CGainsWorks/emb-mixed-signal-daq/hardware/docs/noise_budget.md

<!-- Generated by scripts/run_all.py from model/daqmodel. Edit the model, not this file. -->

# Noise budget

Calculated from the specification before the front end was simulated and
before the behavioural converter existed. Each contributor has its own
closed form transfer function in
[model/daqmodel/noise_budget.py](../../model/daqmodel/noise_budget.py); none
of it uses a circuit solver. The ngspice deck generated from the same
netlist is the independent check (`scripts/run_ngspice.py`, results in
[test-results/noise-floor/ngspice_crosscheck.csv](../../test-results/noise-floor/ngspice_crosscheck.csv)).

## Method

* Temperature 27 degC, the ngspice default, so both routes use the same
  4kT.
* Output referred power spectral density at the converter pins is summed
  over contributors, weighted by the sinc4 decimator's |H(f)|^2 and
  integrated. The decimator response is periodic in f_mod, so the integral
  runs to 2.458 MHz and counts the analogue noise that folds back
  from around the modulator clock. The converter's own noise is defined in
  band and is integrated to f_mod / 2 only.
* Equivalent noise bandwidth of the decimator at 2400 SPS:
  **575.24 Hz**.
* Input referred figures divide by the DC gain of the gain setting.
* Modulator quantisation noise uses the linear model (white error of
  variance 1/3 shaped by the NTF). A 1-bit loop is not linear, so this is a
  conservative estimate; the behavioural model measures the real figure.

## Allowances

The amplifier, converter and reference figures are allowances: what the
budget permits each part to contribute. They are not quoted from a
datasheet and part selection has to meet them.

| Part | Allowance |
|---|---|
| Gain stage amplifiers (zero drift, so no 1/f term) | e_n 6 nV/rtHz, i_n 0.3 pA/rtHz, each |
| Converter, referred to its input | 20 nV/rtHz |
| Reference after its RC filter | 20 nV/rtHz |

## Results by gain

### Gain 1 (actual 1.0000)

| Contributor | Block | Density, nV/rtHz at 10 Hz | rms, nV | Share of power, % | In SPICE deck |
|---|---|---|---|---|---|
| Sensor resistance, 2 x 175 ohm | source | 2.41 | 56.7 | 0.8 | yes |
| Protection resistors, 2 x 499 ohm | input filter | 4.07 | 95.8 | 2.2 | yes |
| Amplifier voltage noise, 2 x 6 nV/rtHz | gain stage | 8.49 | 200.3 | 9.7 | yes |
| Amplifier current noise, 2 x 0.3 pA/rtHz in R_leg | gain stage | 0.29 | 6.7 | 0.0 | yes |
| Feedback resistors R_f, 2 x 2490 ohm | gain stage | 9.09 | 214.4 | 11.1 | yes |
| Anti-alias resistors, 2 x 499 ohm | anti-alias filter | 4.07 | 96.0 | 2.2 | yes |
| Converter input noise, 20 nV/rtHz | converter | 20.00 | 471.8 | 53.7 | no |
| Modulator quantisation (linear model) | converter |  | 290.6 | 20.4 | no |

Total **644.1 nV rms** input referred against a target of
750 nV: meets it with
1.32 dB of margin. The white estimate (low frequency density times
the equivalent noise bandwidth) is 652.6 nV, so the
filter poles above 10 kHz change the total by
1.3 percent. Noise
folded back from above f_mod / 2 is 0.040 percent of the
power. Reference noise adds 339.2 nV rms to a full
scale sine and nothing at zero input.

### Gain 8 (actual 7.9650)

| Contributor | Block | Density, nV/rtHz at 10 Hz | rms, nV | Share of power, % | In SPICE deck |
|---|---|---|---|---|---|
| Sensor resistance, 2 x 175 ohm | source | 2.41 | 56.7 | 5.1 | yes |
| Protection resistors, 2 x 499 ohm | input filter | 4.07 | 95.8 | 14.5 | yes |
| Amplifier voltage noise, 2 x 6 nV/rtHz | gain stage | 8.49 | 200.3 | 63.3 | yes |
| Amplifier current noise, 2 x 0.3 pA/rtHz in R_leg | gain stage | 0.29 | 6.7 | 0.1 | yes |
| Feedback resistors R_f, 2 x 2490 ohm | gain stage | 1.14 | 26.9 | 1.1 | yes |
| Gain resistor R_G, 715 ohm | gain stage | 3.01 | 71.0 | 8.0 | yes |
| Anti-alias resistors, 2 x 499 ohm | anti-alias filter | 0.51 | 12.1 | 0.2 | yes |
| Converter input noise, 20 nV/rtHz | converter | 2.51 | 59.2 | 5.5 | no |
| Modulator quantisation (linear model) | converter |  | 36.5 | 2.1 | no |

Total **251.6 nV rms** input referred against a target of
400 nV: meets it with
4.03 dB of margin. The white estimate (low frequency density times
the equivalent noise bandwidth) is 255.7 nV, so the
filter poles above 10 kHz change the total by
1.6 percent. Noise
folded back from above f_mod / 2 is 0.128 percent of the
power. Reference noise adds 42.6 nV rms to a full
scale sine and nothing at zero input.

### Gain 32 (actual 31.7407)

| Contributor | Block | Density, nV/rtHz at 10 Hz | rms, nV | Share of power, % | In SPICE deck |
|---|---|---|---|---|---|
| Sensor resistance, 2 x 175 ohm | source | 2.41 | 56.7 | 5.9 | yes |
| Protection resistors, 2 x 499 ohm | input filter | 4.07 | 95.8 | 16.9 | yes |
| Amplifier voltage noise, 2 x 6 nV/rtHz | gain stage | 8.49 | 200.3 | 73.8 | yes |
| Amplifier current noise, 2 x 0.3 pA/rtHz in R_leg | gain stage | 0.29 | 6.7 | 0.1 | yes |
| Feedback resistors R_f, 2 x 2490 ohm | gain stage | 0.29 | 6.8 | 0.1 | yes |
| Gain resistor R_G, 162 ohm | gain stage | 1.59 | 37.5 | 2.6 | yes |
| Anti-alias resistors, 2 x 499 ohm | anti-alias filter | 0.13 | 3.0 | 0.0 | yes |
| Converter input noise, 20 nV/rtHz | converter | 0.63 | 14.9 | 0.4 | no |
| Modulator quantisation (linear model) | converter |  | 9.2 | 0.2 | no |

Total **233.1 nV rms** input referred against a target of
320 nV: meets it with
2.75 dB of margin. The white estimate (low frequency density times
the equivalent noise bandwidth) is 236.9 nV, so the
filter poles above 10 kHz change the total by
1.7 percent. Noise
folded back from above f_mod / 2 is 0.134 percent of the
power. Reference noise adds 10.7 nV rms to a full
scale sine and nothing at zero input.

### Gain 128 (actual 128.0408)

| Contributor | Block | Density, nV/rtHz at 10 Hz | rms, nV | Share of power, % | In SPICE deck |
|---|---|---|---|---|---|
| Sensor resistance, 2 x 175 ohm | source | 2.41 | 56.7 | 6.1 | yes |
| Protection resistors, 2 x 499 ohm | input filter | 4.07 | 95.8 | 17.3 | yes |
| Amplifier voltage noise, 2 x 6 nV/rtHz | gain stage | 8.49 | 200.3 | 75.8 | yes |
| Amplifier current noise, 2 x 0.3 pA/rtHz in R_leg | gain stage | 0.29 | 6.7 | 0.1 | yes |
| Feedback resistors R_f, 2 x 2490 ohm | gain stage | 0.07 | 1.7 | 0.0 | yes |
| Gain resistor R_G, 39.2 ohm | gain stage | 0.80 | 18.9 | 0.7 | yes |
| Anti-alias resistors, 2 x 499 ohm | anti-alias filter | 0.03 | 0.7 | 0.0 | yes |
| Converter input noise, 20 nV/rtHz | converter | 0.16 | 3.7 | 0.0 | no |
| Modulator quantisation (linear model) | converter |  | 2.3 | 0.0 | no |

Total **230.1 nV rms** input referred against a target of
300 nV: meets it with
2.31 dB of margin. The white estimate (low frequency density times
the equivalent noise bandwidth) is 233.9 nV, so the
filter poles above 10 kHz change the total by
1.7 percent. Noise
folded back from above f_mod / 2 is 0.134 percent of the
power. Reference noise adds 2.6 nV rms to a full
scale sine and nothing at zero input.

## What the budget says about the design

* At gain 1 the converter's own noise and the modulator quantisation
  dominate, followed by the two feedback resistors. A unity gain buffer
  without R_f would be quieter but the resistors stay because the gain is
  switched by R_G alone.
* From gain 8 up the gain stage amplifiers' voltage noise dominates
  (63 percent of the power at gain 8,
  76 percent at gain 128) and the protection
  resistors are most of the rest, so the noise stops falling with gain.
  Lowering it further means a quieter amplifier or less protection
  resistance, not more gain.
* Amplifier current noise is negligible with this source impedance; it
  would matter only above about 20 kohm per leg.
* Analogue alias rejection at f_mod - 500 Hz is
  **66.9 dB** from the two RC poles
  (11.24 kHz and 15.19 kHz), against a target of
  60 dB.
* Predicted SNR for a -1 dBFS sine at gain 1, reference noise included:
  **126.9 dB**, an ENOB of 20.79 bits before distortion.
