CGainsWorks/emb-mixed-signal-daq/test-results/enob-snr/spectra.png

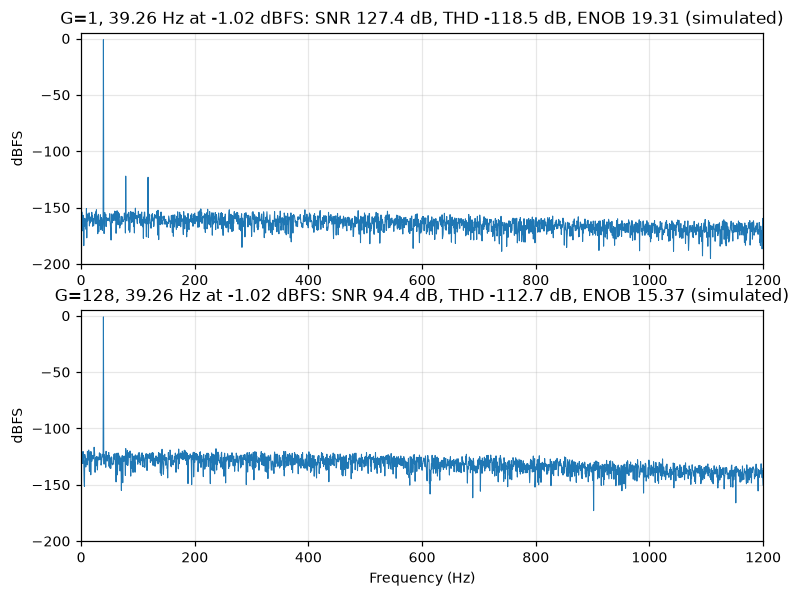
test-results/enob-snr/spectra.png
