CGainsWorks/emb-mixed-signal-daq/test-results/calibration/firmware_in_loop.csv

gain | samples | frames | crc_errors | sequence_gaps | raw_codes_match_model | coefficients_match_python | calibrated_samples_match_python | offset_q8 | gain_q29 | snr_dB_firmware_output | enob_bits_firmware_output
1 | 4096 | 258 | 0 | 0 | yes | yes | 4096/4096 | -31288 | 536896879 | 127.425 | 19.307
128 | 4096 | 258 | 0 | 0 | yes | yes | 4096/4096 | -832220 | 537015455 | 94.351 | 15.371
