CGainsWorks/emb-mixed-signal-daq/test-results/calibration/coefficients.csv

gain | vcal_nV | offset_q8 | gain_q29
1 | 2250000000 | -31372 | 536896937
8 | 281250000 | -75400 | 539418625
32 | 70312500 | -225292 | 541331474
128 | 17578125 | -826804 | 537016852
