CGainsWorks/emb-mixed-signal-daq/test-results/calibration/validation.csv

gain | nominal_V | true_V | dmm_V | daq_raw_V | daq_calibrated_V | raw_error_ppm_fsr | cal_error_vs_dmm_ppm_fsr | cal_error_vs_true_ppm_fsr
1 | -2.2500000 | -2.250001126 | -2.250006378 | -2.249919344 | -2.249991886 | 17.41 | 2.898 | 1.848
1 | -1.8000000 | -1.800000901 | -1.800005080 | -1.799941016 | -1.799991746 | 12.81 | 2.667 | 1.831
1 | -1.3500000 | -1.350000676 | -1.350003783 | -1.349964421 | -1.349993338 | 7.87 | 2.089 | 1.468
1 | -0.9000000 | -0.900000450 | -0.900002485 | -0.899988003 | -0.899995107 | 2.90 | 1.476 | 1.069
1 | -0.4500000 | -0.450000225 | -0.450001187 | -0.450012395 | -0.449997686 | -2.24 | 0.700 | 0.508
1 | -0.0000000 | -0.000000000 | 0.000000110 | -0.000036377 | 0.000000144 | -7.30 | 0.007 | 0.029
1 | 0.4500000 | 0.450000225 | 0.450001408 | 0.449939715 | 0.449998049 | -12.34 | -0.672 | -0.435
1 | 0.9000000 | 0.900000450 | 0.900002706 | 0.899916412 | 0.899996560 | -17.26 | -1.229 | -0.778
1 | 1.3500000 | 1.350000676 | 1.350004003 | 1.349894451 | 1.349996411 | -21.91 | -1.518 | -0.853
1 | 1.8000000 | 1.800000901 | 1.800005301 | 1.799873309 | 1.799997082 | -26.40 | -1.644 | -0.764
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
