CGainsWorks/emb-mixed-signal-daq/test-results/enob-snr/sine.csv

gain | freq_Hz | level_dBFS | snr_dB | budget_snr_dB | thd_dB | sfdr_dB | sinad_dB | enob_bits | enob_ieee1241_bits
1 | 39.2578 | -1.016 | 127.425 | 126.905 | -118.516 | 121.053 | 117.991 | 19.307 | 19.474
128 | 39.2578 | -1.018 | 94.351 | 94.567 | -112.721 | 115.686 | 94.291 | 15.371 | 15.538
