CGainsWorks/emb-mixed-signal-daq/test-results/linearity/inl.csv

applied_V | measured_V | inl_best_fit_ppm_fsr | inl_end_point_ppm_fsr
-2.3750000 | -2.374912407 | -0.056 | 0.000
-2.2562500 | -2.256167941 | 0.065 | 0.088
-2.1375000 | -2.137423456 | 0.190 | 0.181
-2.0187500 | -2.018679501 | 0.208 | 0.167
-1.9000000 | -1.899935249 | 0.286 | 0.212
-1.7812500 | -1.781191677 | 0.228 | 0.122
-1.6625000 | -1.662447490 | 0.293 | 0.155
-1.5437500 | -1.543703564 | 0.306 | 0.135
-1.4250000 | -1.424959991 | 0.248 | 0.045
-1.3062500 | -1.306216111 | 0.252 | 0.016
-1.1875000 | -1.187472325 | 0.237 | -0.032
-1.0687500 | -1.068728631 | 0.203 | -0.098
-0.9500000 | -0.949985050 | 0.147 | -0.186
-0.8312500 | -0.831241552 | 0.074 | -0.292
-0.7125000 | -0.712498147 | -0.017 | -0.415
-0.5937500 | -0.593754314 | -0.023 | -0.454
-0.4750000 | -0.475010769 | -0.087 | -0.549
-0.3562500 | -0.356267206 | -0.146 | -0.642
-0.2375000 | -0.237523606 | -0.199 | -0.726
-0.1187500 | -0.118780183 | -0.286 | -0.847
0.0000000 | -0.000036117 | -0.246 | -0.838
0.1187500 | 0.118706878 | -0.419 | -1.044
0.2375000 | 0.237450926 | -0.382 | -1.039
0.3562500 | 0.356194340 | -0.472 | -1.161
0.4750000 | 0.474938191 | -0.474 | -1.196
0.5937500 | 0.593682155 | -0.453 | -1.208
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
