CGainsWorks/emb-mixed-signal-daq/test-results/noise-floor/ngspice_crosscheck.csv

gain | ngspice_out_nV_rtHz_1Hz | budget_out_nV_rtHz_1Hz | ngspice_in_nV_rms | budget_in_nV_rms | max_density_rel_dev | integrated_rel_dev | max_transfer_rel_dev
1 | 13.9111 | 13.9111 | 328.243 | 328.243 | 2.86e-07 | 4.34e-07 | 2.77e-07
8 | 81.6372 | 81.6371 | 241.803 | 241.803 | 7.03e-07 | 2.59e-07 | 1.46e-07
32 | 312.6802 | 312.6801 | 232.398 | 232.398 | 5.69e-07 | 4.53e-07 | 3.24e-07
128 | 1248.4597 | 1248.4605 | 230.023 | 230.023 | 6.31e-07 | 1.40e-06 | 1.29e-06
