CGainsWorks/emb-mixed-signal-daq/test-results/noise-floor/noise_floor.csv

gain | simulated_uV_rms | budget_uV_rms | target_uV_rms | peak_to_peak_uV | effective_bits | noise_free_bits | overloads
1 | 0.6008 | 0.6441 | 0.750 | 4.172 | 22.989 | 20.266 | 0
8 | 0.2596 | 0.2516 | 0.400 | 1.714 | 21.199 | 18.476 | 0
32 | 0.2271 | 0.2331 | 0.320 | 1.555 | 19.392 | 16.670 | 0
128 | 0.2336 | 0.2301 | 0.300 | 1.742 | 17.351 | 14.629 | 0
