CGainsWorks/emb-mixed-signal-daq/test-results/calibration/errors.png

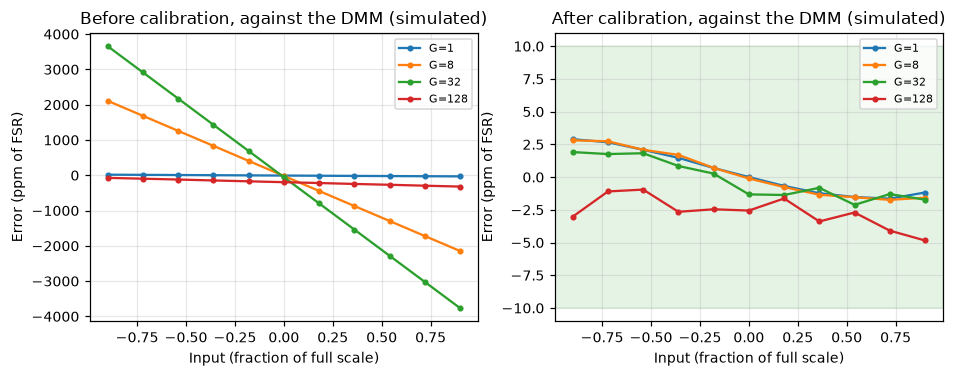
test-results/calibration/errors.png
