CGainsWorks/emb-mixed-signal-daq/test-results/linearity/inl.png

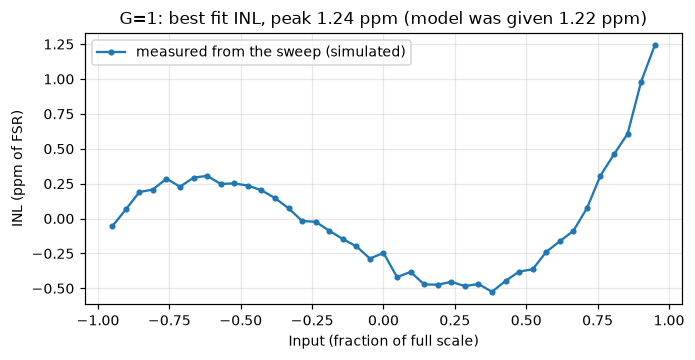
test-results/linearity/inl.png
