CGainsWorks/emb-mixed-signal-daq/test-results/noise-floor/budget_shares.png

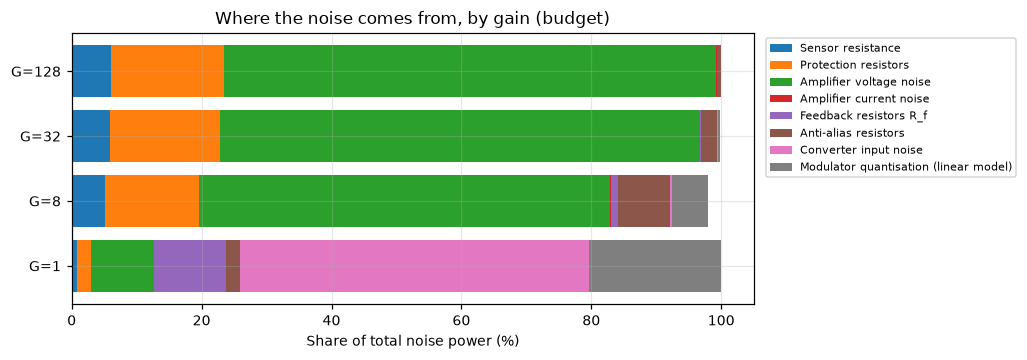
test-results/noise-floor/budget_shares.png
