CGainsWorks/emb-mixed-signal-daq/test-results/noise-floor/histograms.png

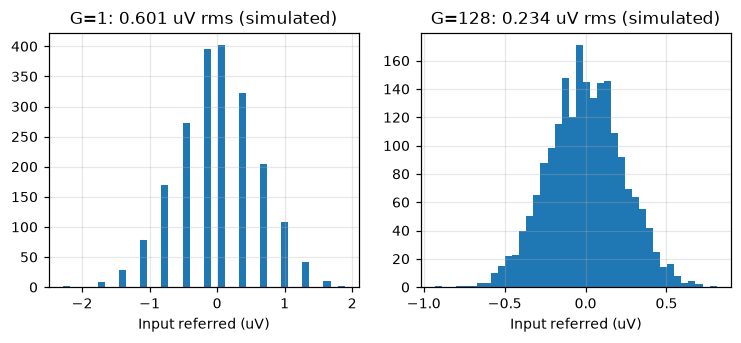
test-results/noise-floor/histograms.png
