CGainsWorks/emb-mixed-signal-daq/hardware/outputs/schematic.pdf

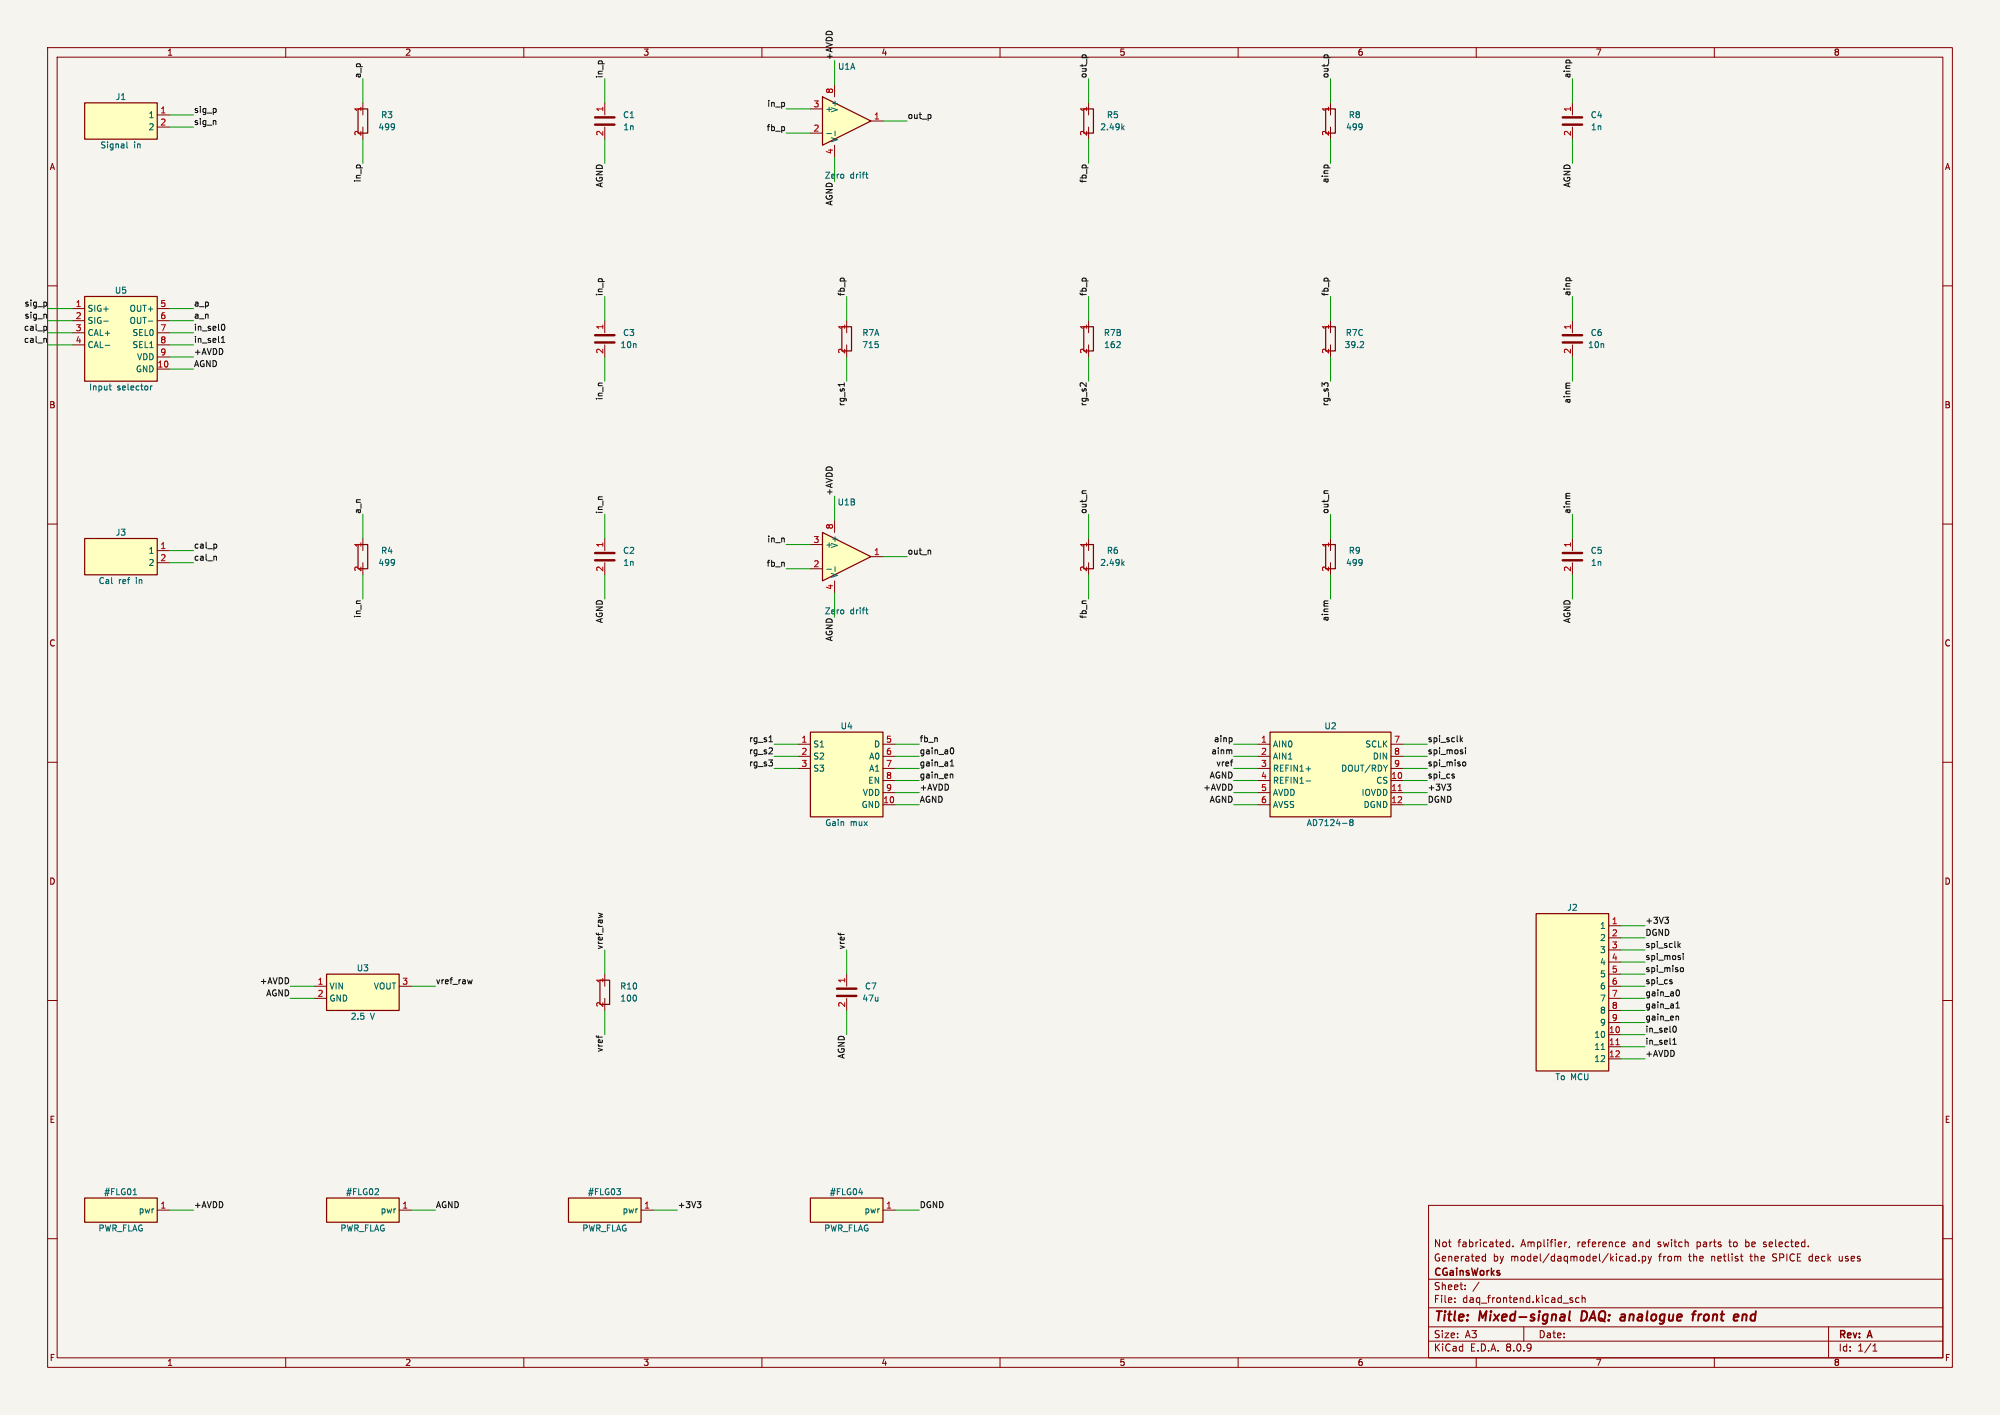
[picture p7: page 1]
