CGainsWorks/emb-mixed-signal-daq/hardware/kicad/daq_frontend.kicad_sch

## KiCad design hardware/kicad/daq_frontend.kicad_sch (2026-10-16)

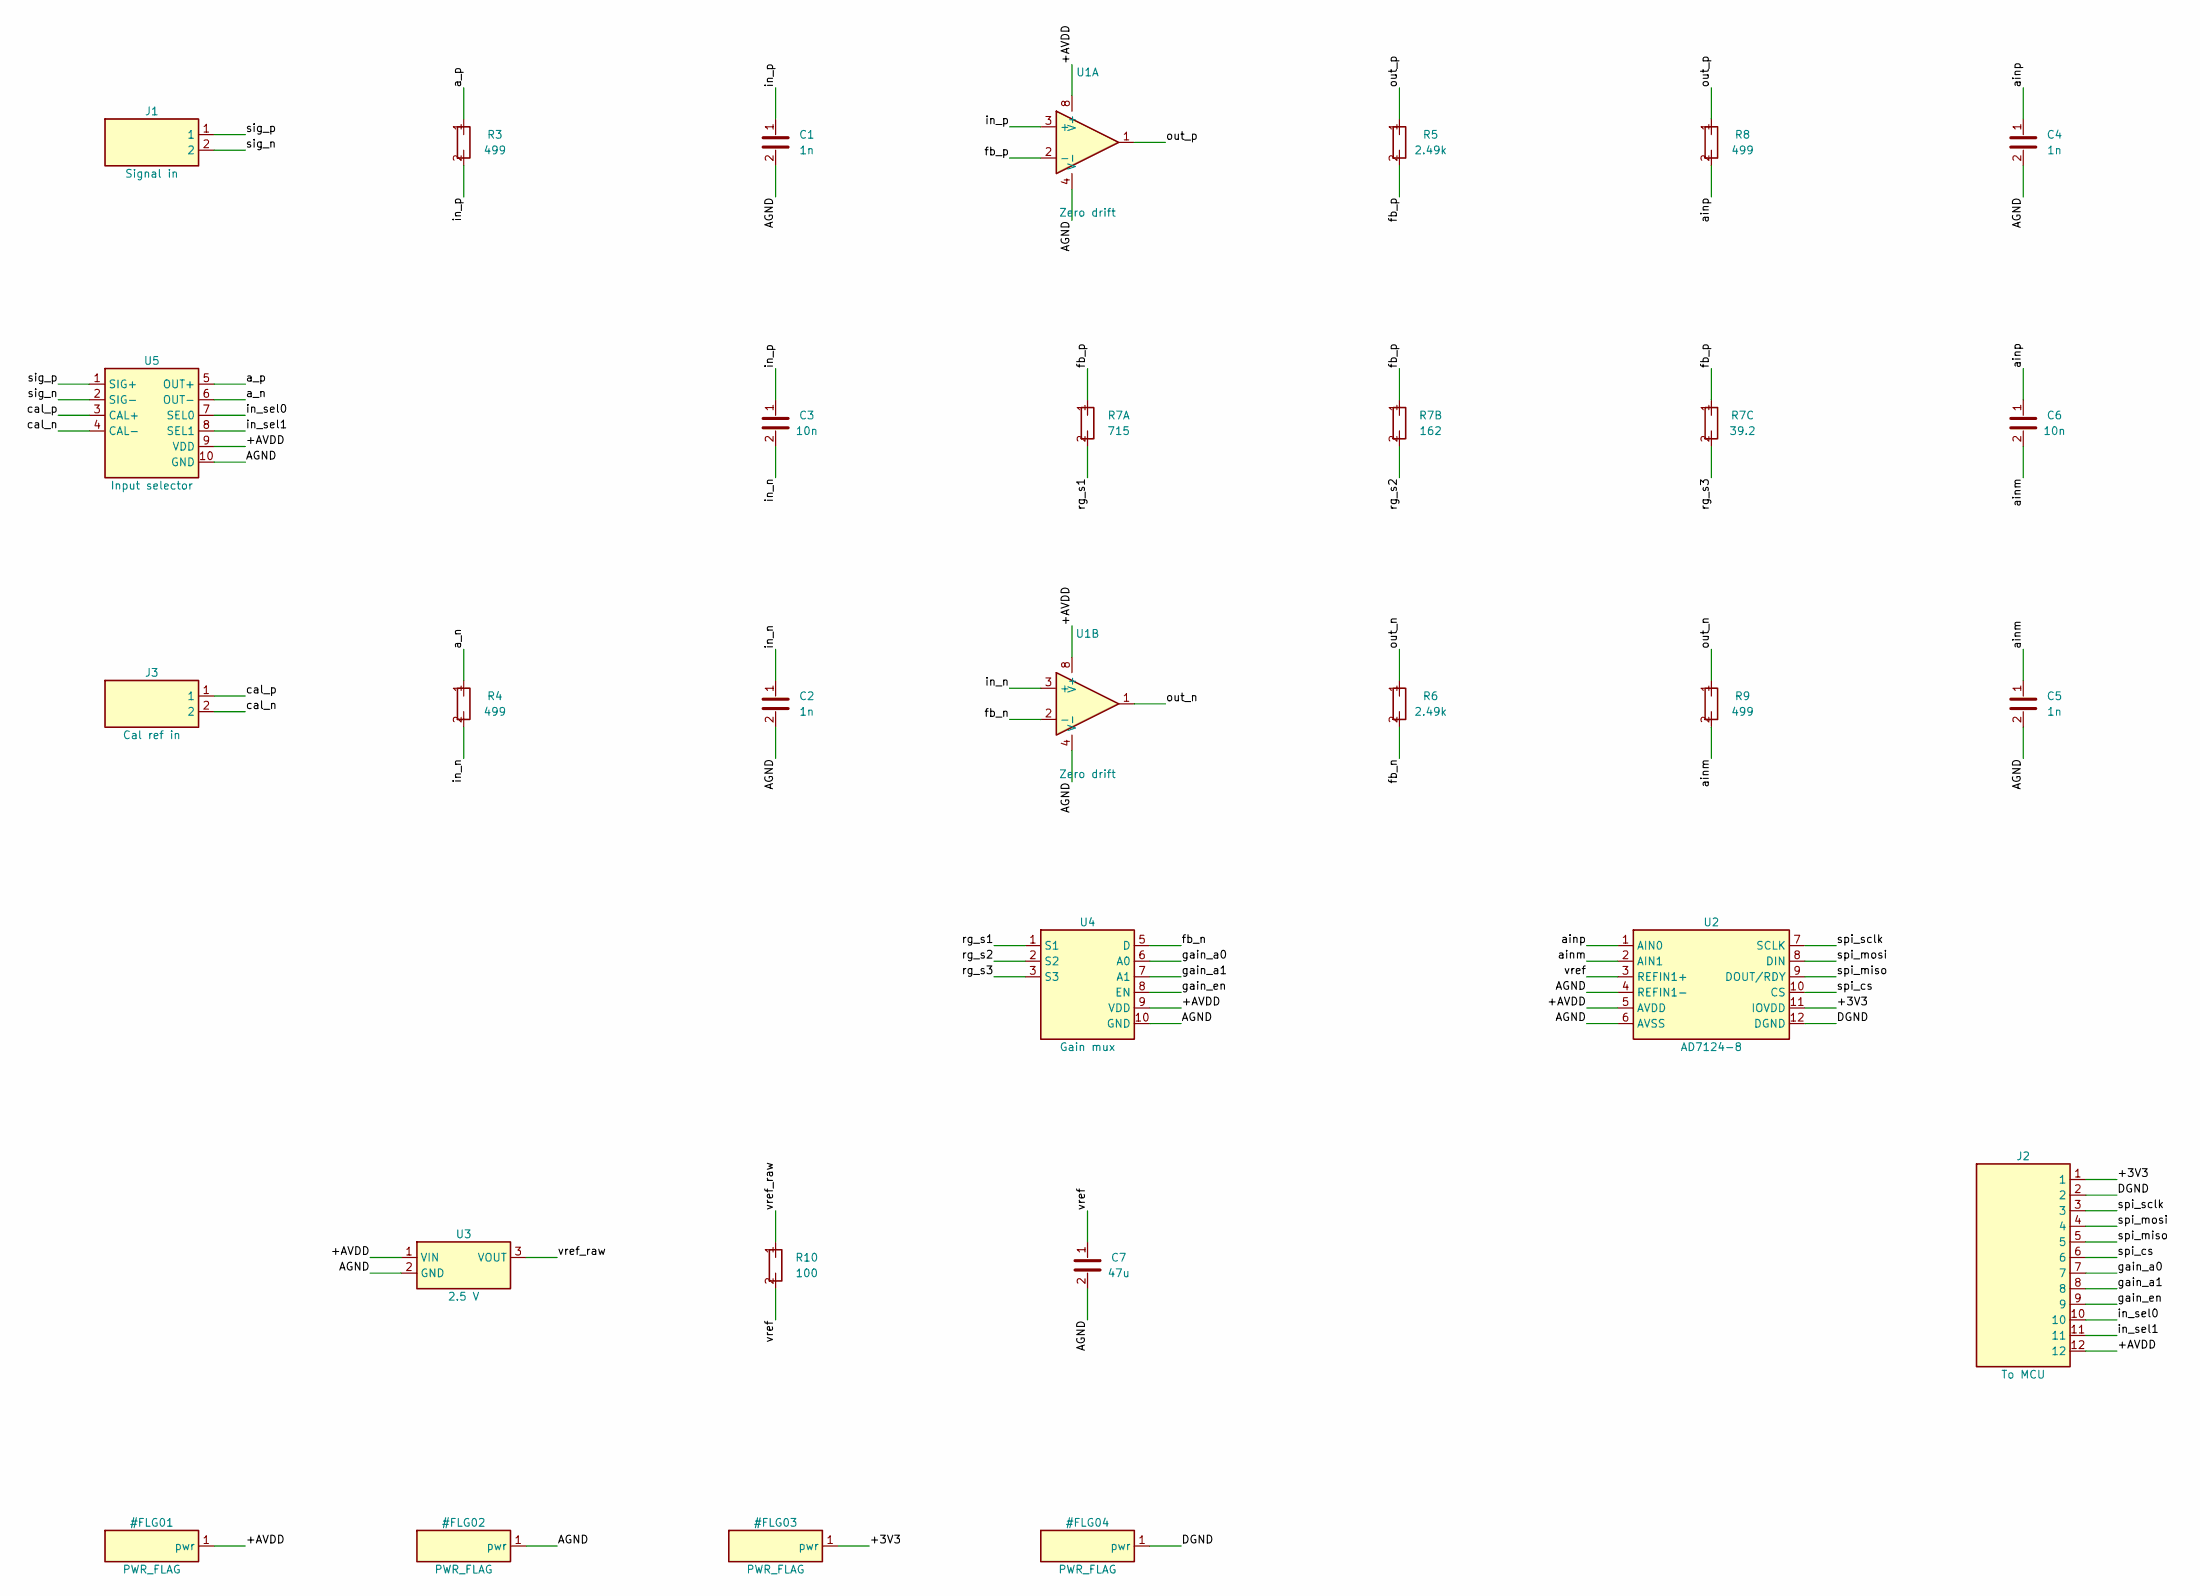
[picture p8: schematic daq_frontend.kicad_sch]

Parts:
C1, C2, C4, C5: 1n; C_0603_1608Metric
C3, C6: 10n; C_0603_1608Metric
C7: 47u; C_1210_3225Metric
J1: Signal in; Conn_01x02
J2: To MCU; Conn_01x12
J3: Cal ref in; Conn_01x02
R3, R4, R8, R9: 499; R_0603_1608Metric
R5, R6: 2.49k; R_0603_1608Metric
R7A: 715; R_0603_1608Metric
R7B: 162; R_0603_1608Metric
R7C: 39.2; R_0603_1608Metric
R10: 100; R_0603_1608Metric
U1A, U1B: Zero drift
U2: AD7124-8; LFCSP-32-1EP_5x5mm_P0.5mm
U3: 2.5 V
U4: Gain mux
U5: Input selector

Connections:
+3V3: J2.1, U2.11 (IOVDD)
+AVDD: J2.12, U1A.8 (V+), U1B.8 (V+), U2.5 (AVDD), U3.1 (VIN), U4.9 (VDD), U5.9 (VDD)
AGND: C1.2, C2.2, C4.2, C5.2, C7.2, U1A.4 (V-), U1B.4 (V-), U2.4 (REFIN1-), U2.6 (AVSS), U3.2 (GND), U4.10 (GND), U5.10 (GND)
DGND: J2.2, U2.12 (DGND)
a_n: R4.1, U5.6 (OUT-)
a_p: R3.1, U5.5 (OUT+)
ainm: C5.1, C6.2, R9.2, U2.2 (AIN1)
ainp: C4.1, C6.1, R8.2, U2.1 (AIN0)
cal_n: J3.2, U5.4 (CAL-)
cal_p: J3.1, U5.3 (CAL+)
fb_n: R6.2, U1B.2 (-), U4.5 (D)
fb_p: R5.2, R7A.1, R7B.1, R7C.1, U1A.2 (-)
gain_a0: J2.7, U4.6 (A0)
gain_a1: J2.8, U4.7 (A1)
gain_en: J2.9, U4.8 (EN)
in_n: C2.1, C3.2, R4.2, U1B.3 (+)
in_p: C1.1, C3.1, R3.2, U1A.3 (+)
in_sel0: J2.10, U5.7 (SEL0)
in_sel1: J2.11, U5.8 (SEL1)
out_n: R6.1, R9.1, U1B.1
out_p: R5.1, R8.1, U1A.1
rg_s1: R7A.2, U4.1 (S1)
rg_s2: R7B.2, U4.2 (S2)
rg_s3: R7C.2, U4.3 (S3)
sig_n: J1.2, U5.2 (SIG-)
sig_p: J1.1, U5.1 (SIG+)
spi_cs: J2.6, U2.10 (CS)
spi_miso: J2.5, U2.9 (DOUT/RDY)
spi_mosi: J2.4, U2.8 (DIN)
spi_sclk: J2.3, U2.7 (SCLK)
vref: C7.1, R10.2, U2.3 (REFIN1+)
vref_raw: R10.1, U3.3 (VOUT)
